smitzkar/treebot-smitzkar/src/esp32vine_karl_USB/esp32vine_karl_USB.ino

// now pure usb communication

// 2026-01-18 Karl changes
// - redid wiring and assigned different GPIO pins to simplify wire salad
// - brought all pin assignents to the top
// - renamed confusing ledPin to signalPiPin (re revert: search and replace)
// 01-20 IT WORKS!!
// - fixed a whole bunch of issues
// - added basic error handling
// - set to purple when there hasn't been any communication from the pi (either on boot, or error)
// --> "waiting to be touched to retry this"
// 01-22 MOVE TO USB
// - insufficient power supply is still the bottleneck
// - fixed logical error in error mode, added 10k pulldown to RX to ignore noise
// - no more UART mixed up nonsense
// - pi powers esp32 and communicates with it over usb
// - led-strip has own power supply (data/gnd <-> esp32)


// colours:
// - white: setup complete
// - purple: calibrating 
// - red: error, didn't receive response from pi -> touch to retry
// - "breathing" white: waiting to be touched
// - green: listening
// - blue/white running: thinking
// - blue: speaking

#include <FastLED.h>

const bool touchToSerialPrint = false; // set this true if you want the original constant stream of values

const int touchPin = 27;   // Touch input (ESP32: e.g. GPIO27)

// ---------- LED strip ----------
#define NUM_LEDS     144 // pulls >2A in white idle animation!
#define LED_PIN      13     // was 18
#define LED_TYPE     WS2812B
#define COLOR_ORDER  GRB
CRGB leds[NUM_LEDS];

// ---------- Pi Communication Monitoring ----------
// this is meant to give some visual feedback on whether or not the communication to pi works
unsigned long touchSignalSentTime = 0;
const unsigned long PI_RESPONSE_TIMEOUT = 2000; // 2 seconds to respond to touch
bool touchSignalSent = false;
bool errorMode = false; // start in normal mode
bool previousErrorMode = false;
bool waitingForPiResponse = false;


// Modify these globals:
const int TOUCH_MARGIN = 20;        // How much below baseline = touch
const int RELEASE_MARGIN = 30;      // How much below baseline = release (higher for stability)
bool currentlyTouched = false;

// Add these variables at the top with other globals:
unsigned long lastRecalibration = 0;
const unsigned long recalibrationInterval = 300000; // 5 minutes
const int BASELINE_SAMPLES = 50;
int baselineReadings[BASELINE_SAMPLES];
int baselineIndex = 0;
bool baselineReady = false;

int threshold = 0;          // Touch-Schwelle (Kalibrierung)
bool calibrated = false;    // Kalibrierungs-Status

const int N = 31;           // Anzahl Samples für Median (ungerade)
int buffer[N];

// Timer für 2s Haltezeit
unsigned long mytouchStart = 0;
const unsigned long holdTime = 2000; // 2 Sekunden

// ---------- Pulse (breathing) control ----------
bool pulseActive = false;
bool wanderingDotsActive = false;
uint8_t pulseBPM = 12;       // lower = slower, smoother breathing
uint8_t minBright = 10;     // floor brightness
uint8_t maxBright = 160;    // 255 ceiling brightness

const uint16_t pulseIntervalMs = 20;
uint32_t lastPulseMs = 0;



// ---------- Helpers ----------

//MARK: error handling
void enterErrorMode() {
  stopPulse();
  fill_solid(leds, NUM_LEDS, CRGB::Red);
  FastLED.setBrightness(50); 
  FastLED.show();
  Serial.println("⚠ ERROR MODE: Pi didn't respond to touch");
}
/* Just quick visual feedback: leds to white */
void exitErrorMode() {
  stopPulse();
  fill_solid(leds, NUM_LEDS, CRGB::White);
  FastLED.setBrightness(25); 
  FastLED.show();
}
inline bool allowVisualOutput() {
  // a sort of gate used in the animation setting functions 
  // determines whether or not they should actually update the leds (don't override error)
  return !errorMode;
}


void startPulse(CRGB color) {
  wanderingDotsActive = false;
  pulseActive = true;
  if (!allowVisualOutput()) return;
  fill_solid(leds, NUM_LEDS, color);
  FastLED.setBrightness(maxBright);
  FastLED.show();
}

void startWanderingDots() {
  if (!allowVisualOutput()) return;
  pulseActive = false;
  wanderingDotsActive = true;
  fill_solid(leds, NUM_LEDS, CRGB::Blue);
  FastLED.show();
}

void updateWanderingDots() {
  if (!allowVisualOutput()) return;
  static uint8_t offset = 0;
  static unsigned long lastUpdate = 0;
  
  if (millis() - lastUpdate < 120) return;
  lastUpdate = millis();
  
  const CRGB background = CRGB::Blue;
  const CRGB dotColor = CRGB::White;
  const int dotGroupCount = 3;
  const int dotGroupSizeMin = 4;
  const int dotGroupSizeMax = 16;

  fill_solid(leds, NUM_LEDS, background);

  for (int g = 0; g < dotGroupCount; g++) {
    int groupPos = (offset + (g * (NUM_LEDS / dotGroupCount))) % NUM_LEDS;
    int groupSize = random(dotGroupSizeMin, dotGroupSizeMax + 1);
    for (int i = 0; i < groupSize; i++) {
      leds[(groupPos + i) % NUM_LEDS] = dotColor;
    }
  }

  FastLED.show();
  offset = (offset - 5 + NUM_LEDS) % NUM_LEDS; //reverse direction
}


void stopPulse() {
  pulseActive = false;
  wanderingDotsActive = false;
  if (!allowVisualOutput()) return;
  fill_solid(leds, NUM_LEDS, CRGB::Black);
  FastLED.show();
}

void updatePulse() {
  if (!allowVisualOutput()) return;
  uint8_t brightness = beatsin8(pulseBPM, minBright, maxBright);
  FastLED.setBrightness(brightness);
  FastLED.show();
}

bool handleCommand(const String& line) {
  if (line.equalsIgnoreCase("1") || line.equalsIgnoreCase("1.00")) {
    stopPulse();
    delay(100);
    startPulse(CRGB::White); // white pulsating
  } else if (line.equalsIgnoreCase("2") || line.equalsIgnoreCase("2.00")) {
    stopPulse();
    delay(100);
    startPulse(CRGB::Green); // green pulsating
  } else if (line.equalsIgnoreCase("3") || line.equalsIgnoreCase("3.00")) {
    stopPulse();
    delay(100);
    startPulse(CRGB::Blue); // blue pulsating
  } else if (line.equalsIgnoreCase("8") || line.equalsIgnoreCase("8.00")) {
    stopPulse();
    delay(100);
    startWanderingDots(); // blue and white dots
  } else if (line.equalsIgnoreCase("0") || line.equalsIgnoreCase("0.00")) {
    stopPulse();
  } else return false; // not a valid command
  return true;
}


int readMedian(int pin) {
  for (int i = 0; i < N; i++) {
    buffer[i] = touchRead(pin);
    delay(2);
  }
  for (int i = 0; i < N - 1; i++) {
    for (int j = 0; j < N - i - 1; j++) {
      if (buffer[j] > buffer[j + 1]) {
        int tmp = buffer[j];
        buffer[j] = buffer[j + 1];
        buffer[j + 1] = tmp;
      }
    }
  }
  return buffer[N / 2];
}

// Add this function after readMedian():
void updateBaseline(int value) {
  // Only update baseline when NOT touched
  if (value >= threshold + 10) {  // Safety margin above threshold
    baselineReadings[baselineIndex] = value;
    baselineIndex = (baselineIndex + 1) % BASELINE_SAMPLES;
    if (baselineIndex == 0) baselineReady = true;
  }
}

int calculateBaselineThreshold() {
  if (!baselineReady) return threshold;
  
  long sum = 0;
  for (int i = 0; i < BASELINE_SAMPLES; i++) {
    sum += baselineReadings[i];
  }
  return (sum / BASELINE_SAMPLES) - 20;
}


//MARK: setup
void setup() {

  Serial.begin(115200);
  delay(100); // give Serial a moment to init (sometimes this helps and it doesn't hurt)

  Serial.println("Calibration (5 seconds)... do not touch!");
  long sum = 0;
  int count = 0;
  unsigned long start = millis();

  // visual info that thing is calibrating
  FastLED.addLeds<LED_TYPE, LED_PIN, COLOR_ORDER>(leds, NUM_LEDS);
  FastLED.setBrightness(25); // was 255
  fill_solid(leds, NUM_LEDS, CRGB::Purple); // this was set to Black?
  FastLED.show();

  while (millis() - start < 5000) {
    int val = touchRead(touchPin);
    sum += val;
    count++;
    delay(50);
  }

  threshold = (sum / count) - 20;
  calibrated = true;

  Serial.print("Calibration done. Threshold = ");
  Serial.println(threshold);

  // setup complete
  fill_solid(leds, NUM_LEDS, CRGB::White); // this was set to Black?
  FastLED.show();
  Serial.println("[ESP32] Booted. Waiting for Pi commands...");
}

//MARK: loop
void loop() {

  // the order of this and the logic is a bit of a mess, but it works
  // check if Pi properly responded to touch
  if (waitingForPiResponse && !errorMode &&
      (millis() - touchSignalSentTime > PI_RESPONSE_TIMEOUT)) {
    errorMode = true;
  }
  // error mode transitions
  if (errorMode && !previousErrorMode) {
    enterErrorMode();
  } else if (!errorMode && previousErrorMode) {
    exitErrorMode();
  }
  previousErrorMode = errorMode;

  // update touch
  int val = readMedian(touchPin);
  if (touchToSerialPrint){
    Serial.print("Touch value: ");
    Serial.print(val);
    Serial.print(" | Threshold: ");
    Serial.println(threshold);
  }
  // Update baseline with non-touch readings
  updateBaseline(val);

  // Periodic recalibration (every 5 minutes when idle)
  if (millis() - lastRecalibration > recalibrationInterval && mytouchStart == 0) {
    int newThreshold = calculateBaselineThreshold();
    // More conservative sanity check
    if (newThreshold > 0 && abs(newThreshold - threshold) < 15) {
      threshold = newThreshold;
      Serial.print("✓ Recalibrated threshold: ");
      Serial.println(threshold);
    } else {
      Serial.println("✗ Recalibration rejected - too much drift");
    }
    lastRecalibration = millis();
  }

  // Hysteresis-based touch detection
  if (calibrated) {
    if (!currentlyTouched && val < (threshold - TOUCH_MARGIN)) {
      // Touch detected
      currentlyTouched = true;
      mytouchStart = millis();
      Serial.println("→ Touch START");

      if (errorMode) {
        errorMode = false;
        touchSignalSent = false;
        waitingForPiResponse = false;
        Serial.println("↻ Retrying after error");
      }
    } 
    else if (currentlyTouched && val > (threshold - RELEASE_MARGIN)) {
      currentlyTouched = false;
      mytouchStart = 0;
      Serial.println("← Touch RELEASE");
    }

    if (currentlyTouched && !touchSignalSent && (millis() - mytouchStart >= holdTime)) {
      waitingForPiResponse = true;
      touchSignalSentTime = millis();
      touchSignalSent = true;
      Serial.println("✓ Held for 2s");
      Serial.println("TOUCH"); // this is what the pi is listening for
    }

  }

  // ----- Read commands from Raspberry Pi -----
  if (Serial.available()) {
    String line = Serial.readStringUntil('\n');
    line.trim();

    // 🧹 Entferne nicht druckbare Zeichen
    for (int i = 0; i < line.length(); i++) {
      if (line[i] < 32 || line[i] > 126) {
        line.remove(i, 1);
        i--;
      }
    }

    if (line.length()) {
      Serial.print("[ESP32] <- Pi: ");
      Serial.println(line);

      // check if valid command received 
      // (this should really be the place where all the error handling should be, but I'm too lazy to refactor)
      bool handled = handleCommand(line);
      if (handled) {
        errorMode = false;  
        waitingForPiResponse = false;
        touchSignalSent = false; // reset (not necessary, but handles potential issues?)
      }

      handleCommand(line);
    }
  }

  if (pulseActive) {
    uint32_t now = millis();
    if (now - lastPulseMs >= pulseIntervalMs) {
      lastPulseMs = now;
      updatePulse();
    }
  } else if (wanderingDotsActive) {
    updateWanderingDots();
  }

  delay(1);
}
